dennischang928/Line-Follower/Paper/42d4a8cd9a13b9cb2ff5e50058281d6c.png

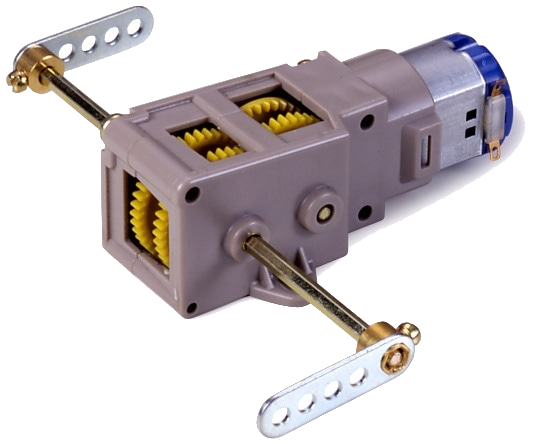
Paper/42d4a8cd9a13b9cb2ff5e50058281d6c.png
