dennischang928/Line-Follower/Paper/Minimalist modern Annual Report.pdf

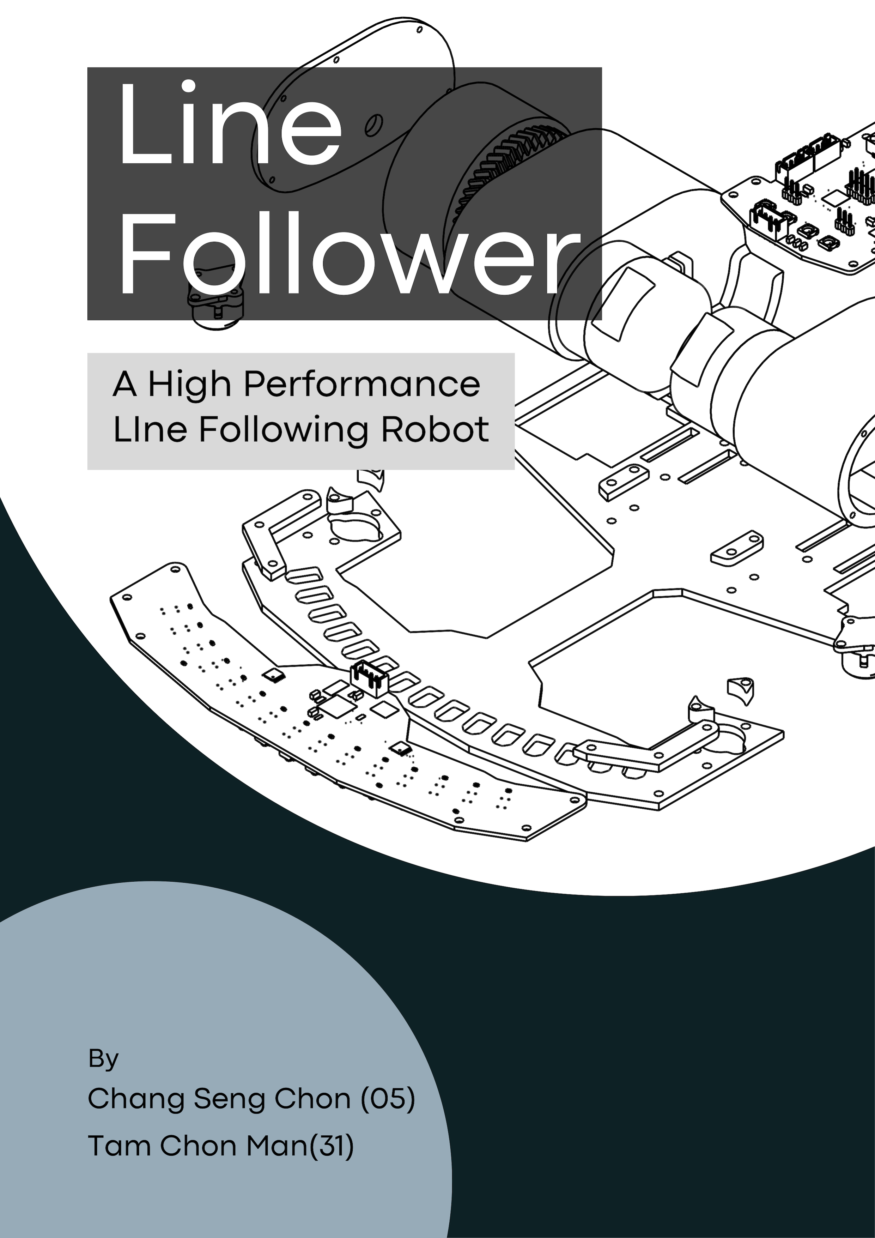
[picture p2: page 1]
