dennischang928/Line-Follower/Paper/Minimalist modern Annual Report (1).pdf

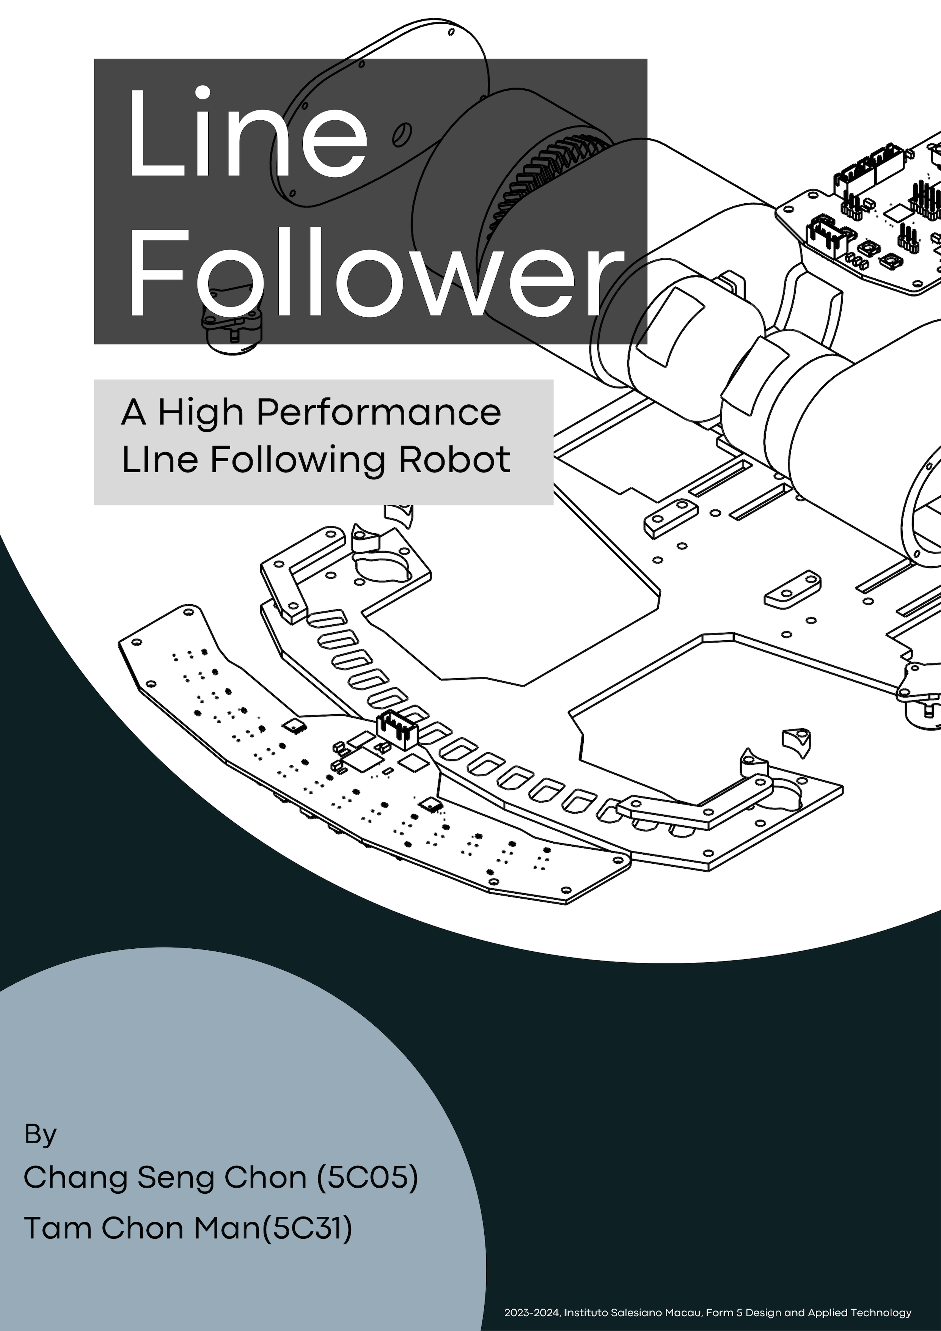
[picture p3: page 1]
