dennischang928/Line-Follower/Hardware/MotherBrd/CAMOUTPUT/MotherBrd v58.png

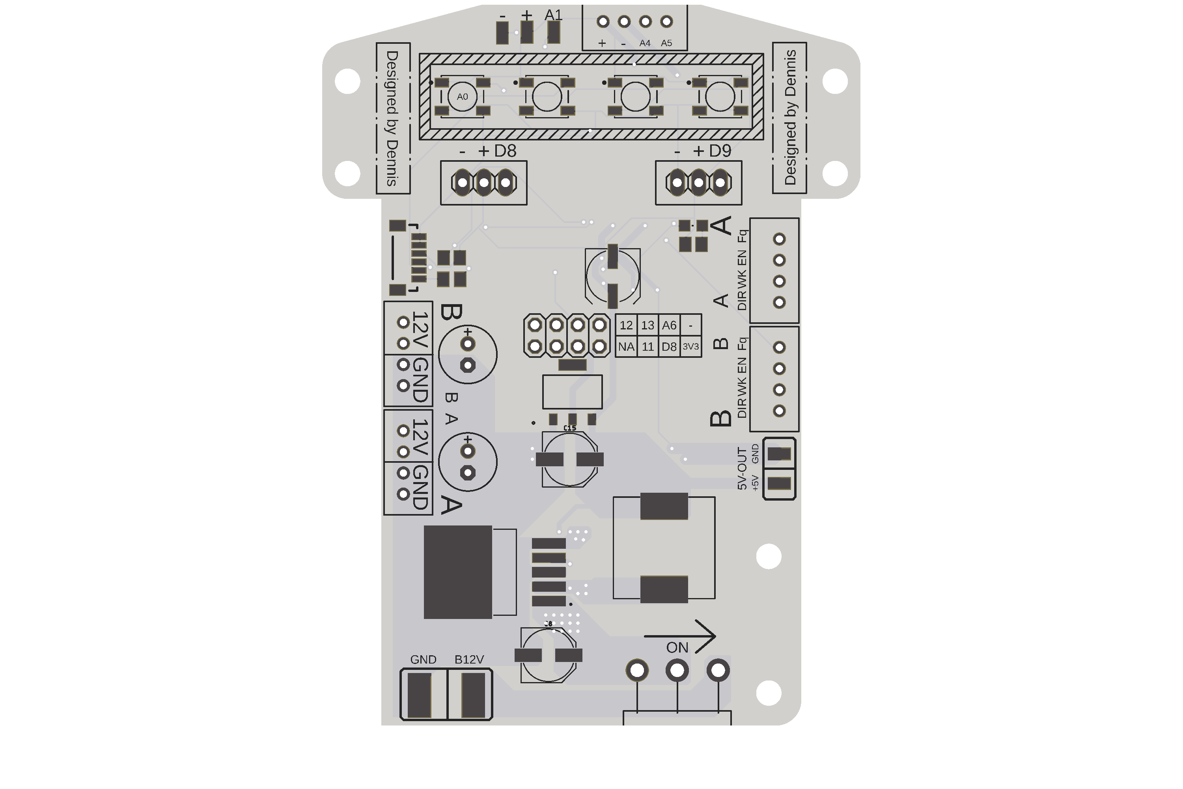
Hardware/MotherBrd/CAMOUTPUT/MotherBrd v58.png
