dennischang928/Line-Follower/Paper/Driving.png

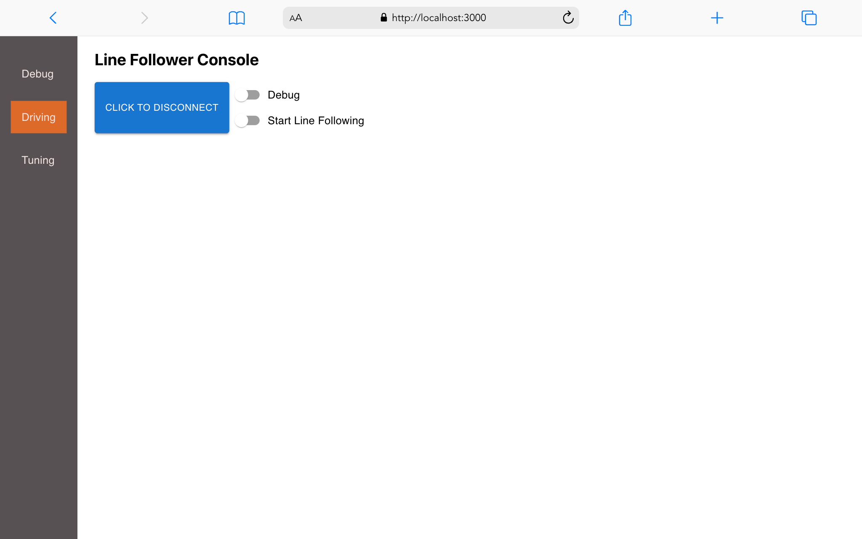
Paper/Driving.png
