dennischang928/Line-Follower/Paper/image.png

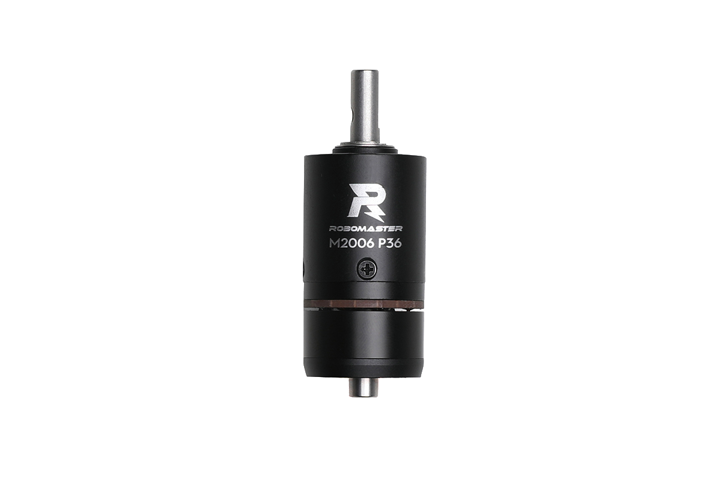
Paper/image.png
