dennischang928/Line-Follower/Paper/Macbook.jpeg

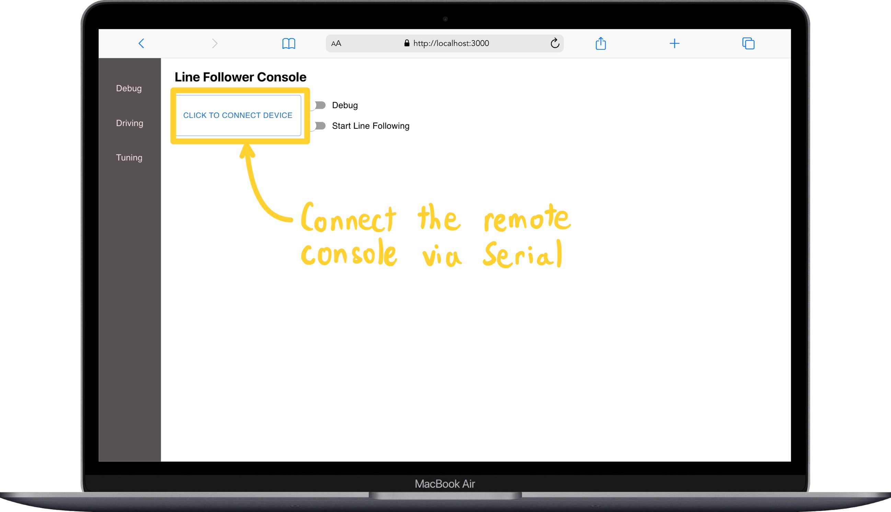
Paper/Macbook.jpeg
