dennischang928/Line-Follower/Paper/mobile.png

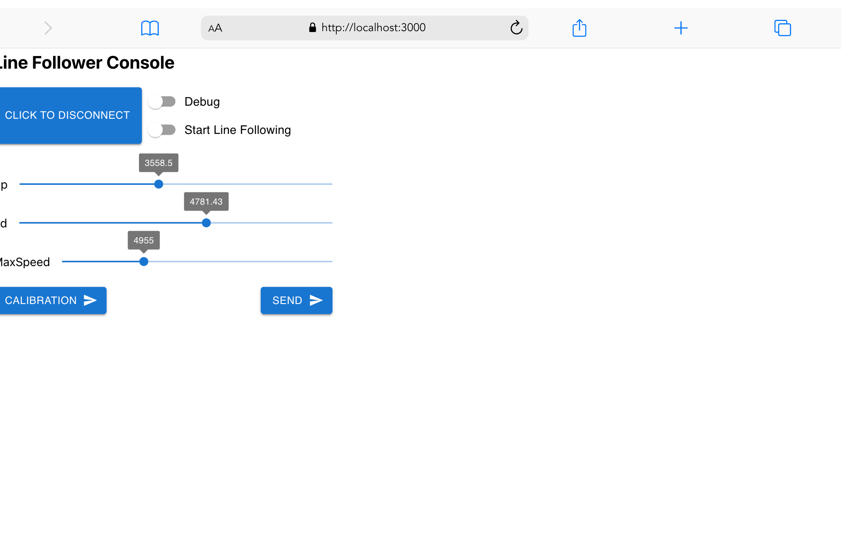
Paper/mobile.png
