dennischang928/Line-Follower/Paper/MotherBrd Buttom.png

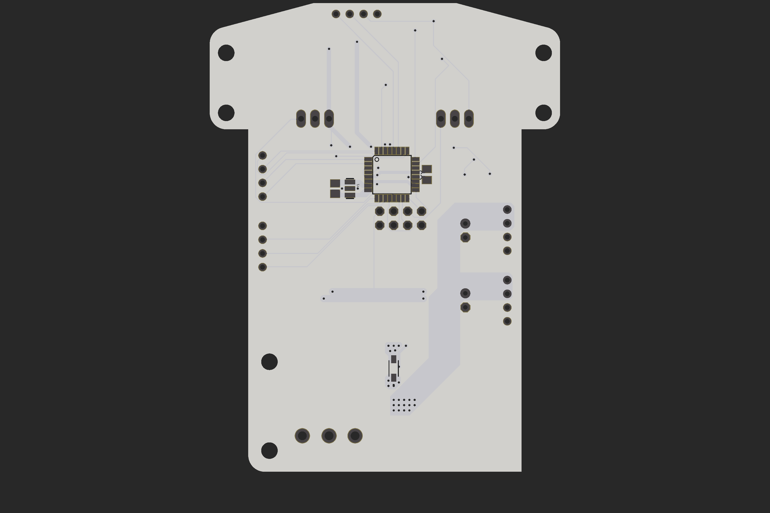
Paper/MotherBrd Buttom.png
