dennischang928/Line-Follower/Paper/Screenshot 2023-11-26 at 12.29.49 PM.png

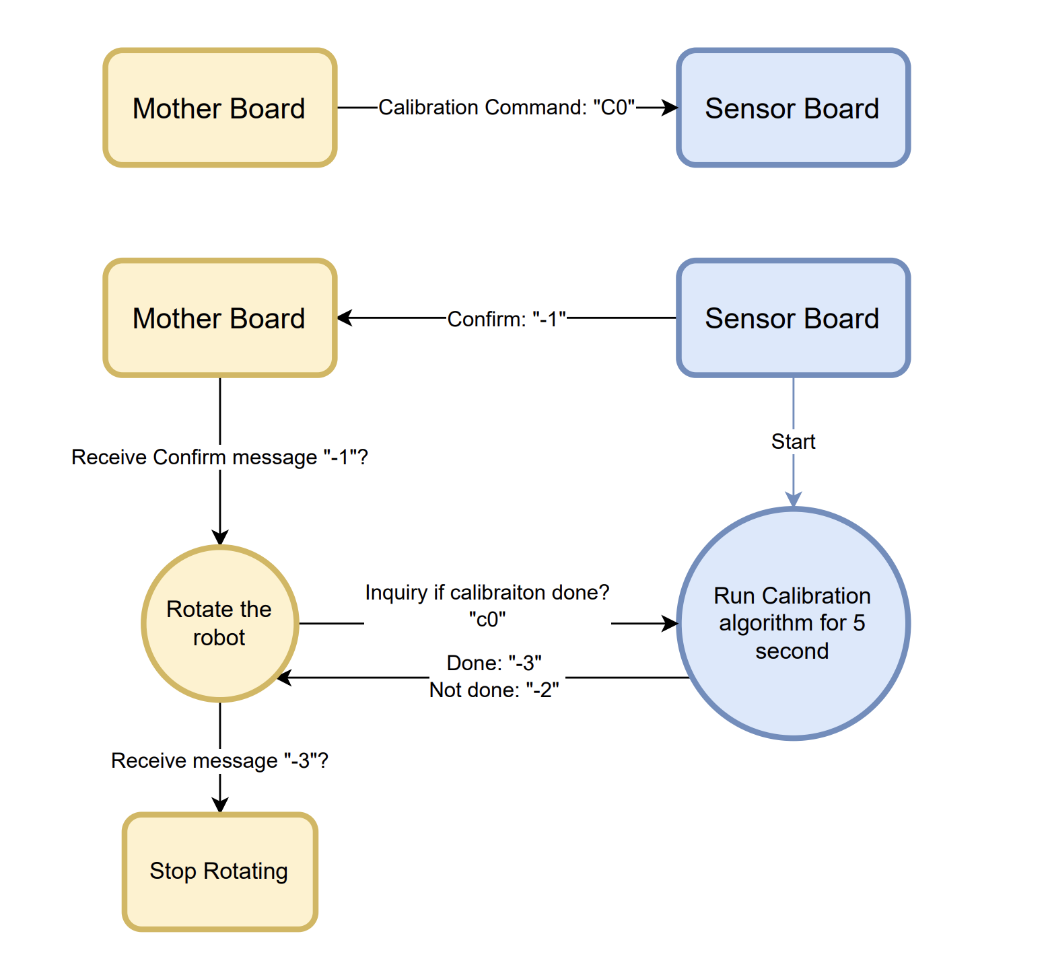
Paper/Screenshot 2023-11-26 at 12.29.49 PM.png
