dennischang928/Line-Follower/Paper/Screenshot 2023-11-26 at 12.39.15 PM.png

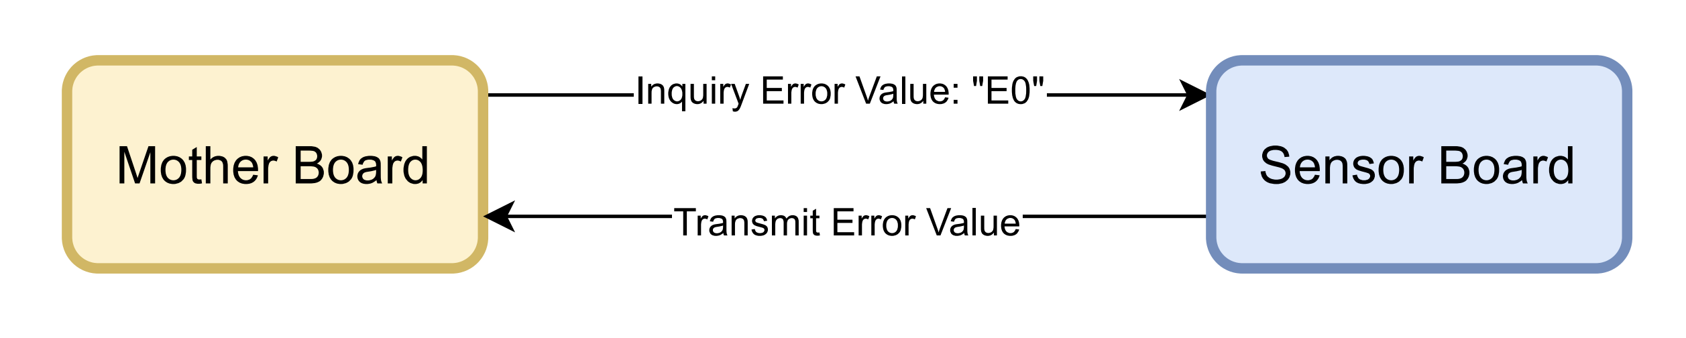
Paper/Screenshot 2023-11-26 at 12.39.15 PM.png
