dennischang928/Line-Follower/Paper/sensor v32.png

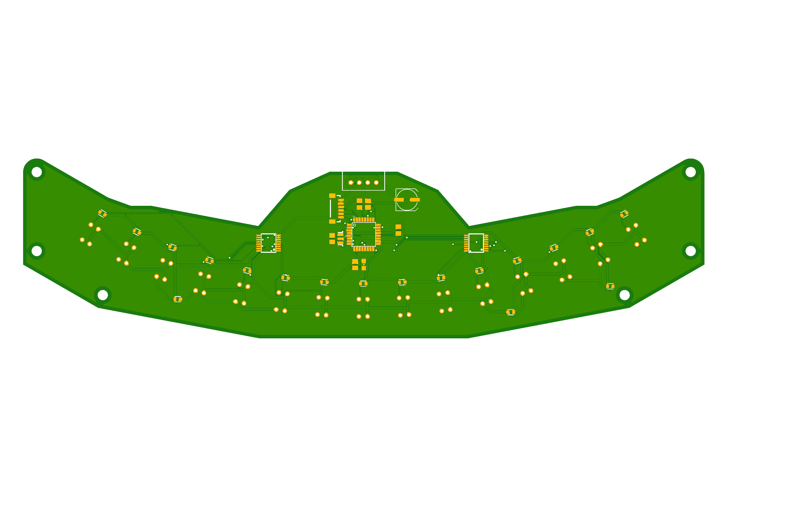
Paper/sensor v32.png
