dennischang928/Line-Follower/Paper/System flow chart.png

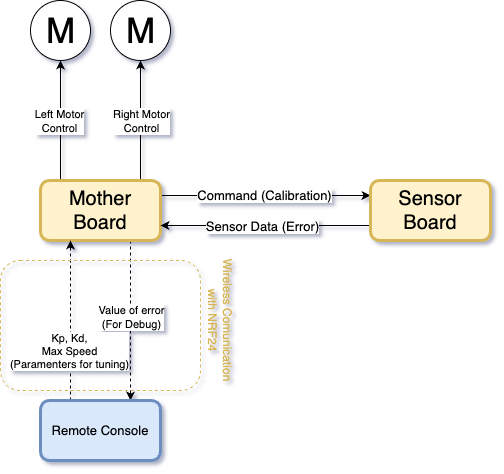
Paper/System flow chart.png
