dennischang928/Line-Follower/Hardware/Manufacter/Bottom_Brd.dxf

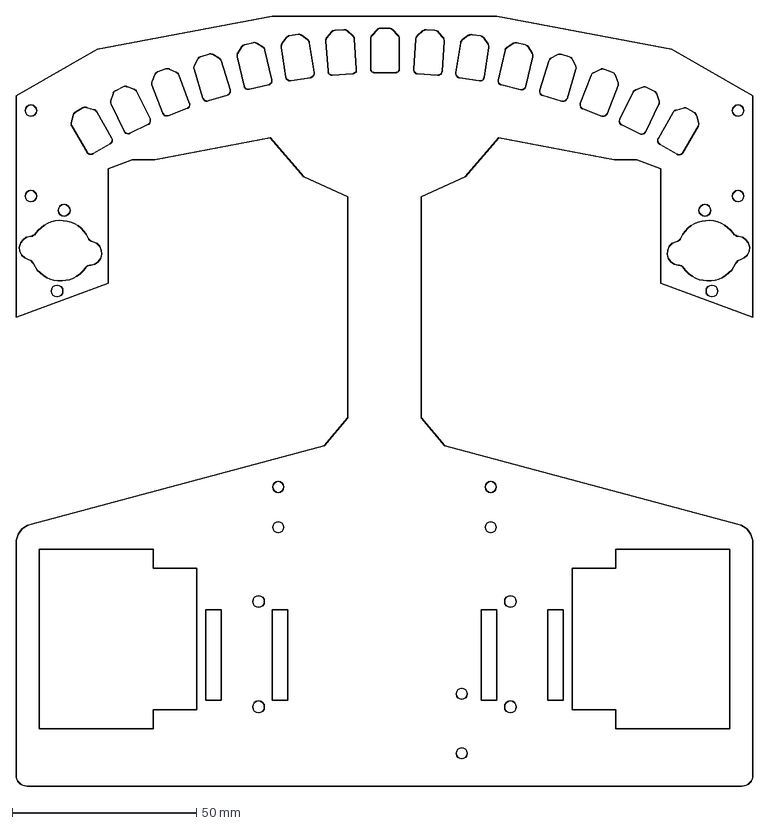
[picture p14: CAD file, 2023-11-18]
Hardware/Manufacter/Bottom_Brd.dxf
200.0 x 209.0 mm
