dennischang928/Line-Follower/Reference/brushless-4056-fan-1.snapshot.2/4056 Fan.STEP

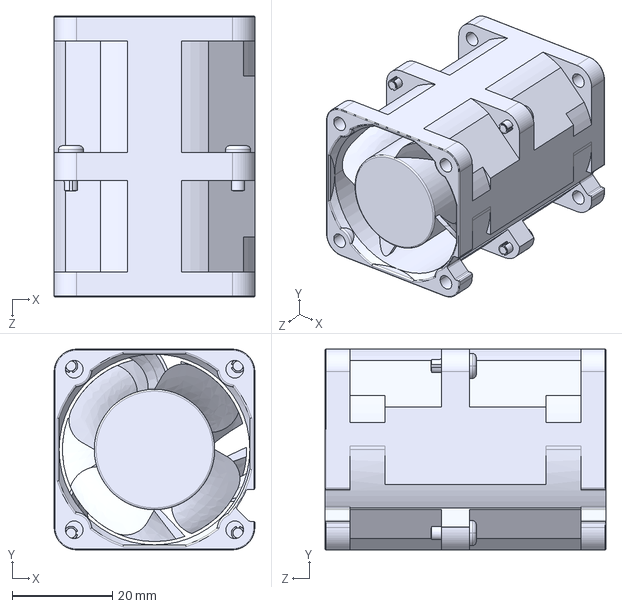
[picture p15: CAD file, 2023-11-18]
Reference/brushless-4056-fan-1.snapshot.2/4056 Fan.STEP
40.0 x 40.0 x 56.0 mm
