dennischang928/Line-Follower/Hardware/Manufacter/Base_Brd.dxf

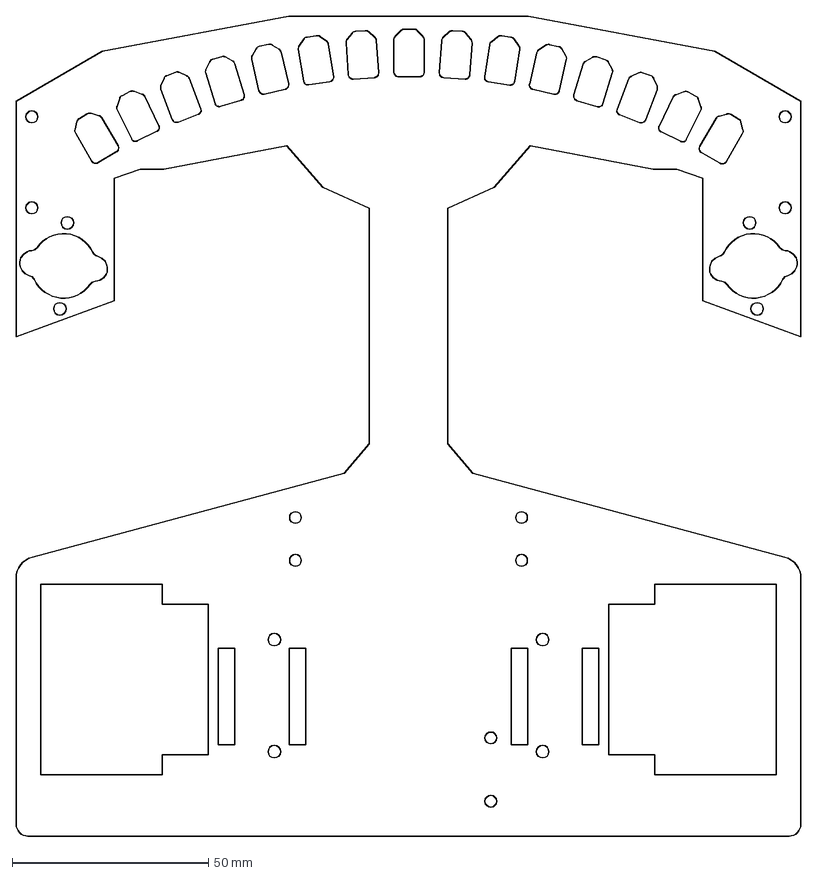
[picture p16: CAD file, 2023-11-18]
Hardware/Manufacter/Base_Brd.dxf
200.0 x 209.0 mm
