dennischang928/Line-Follower/Paper/Untitled Sheet1.dxf

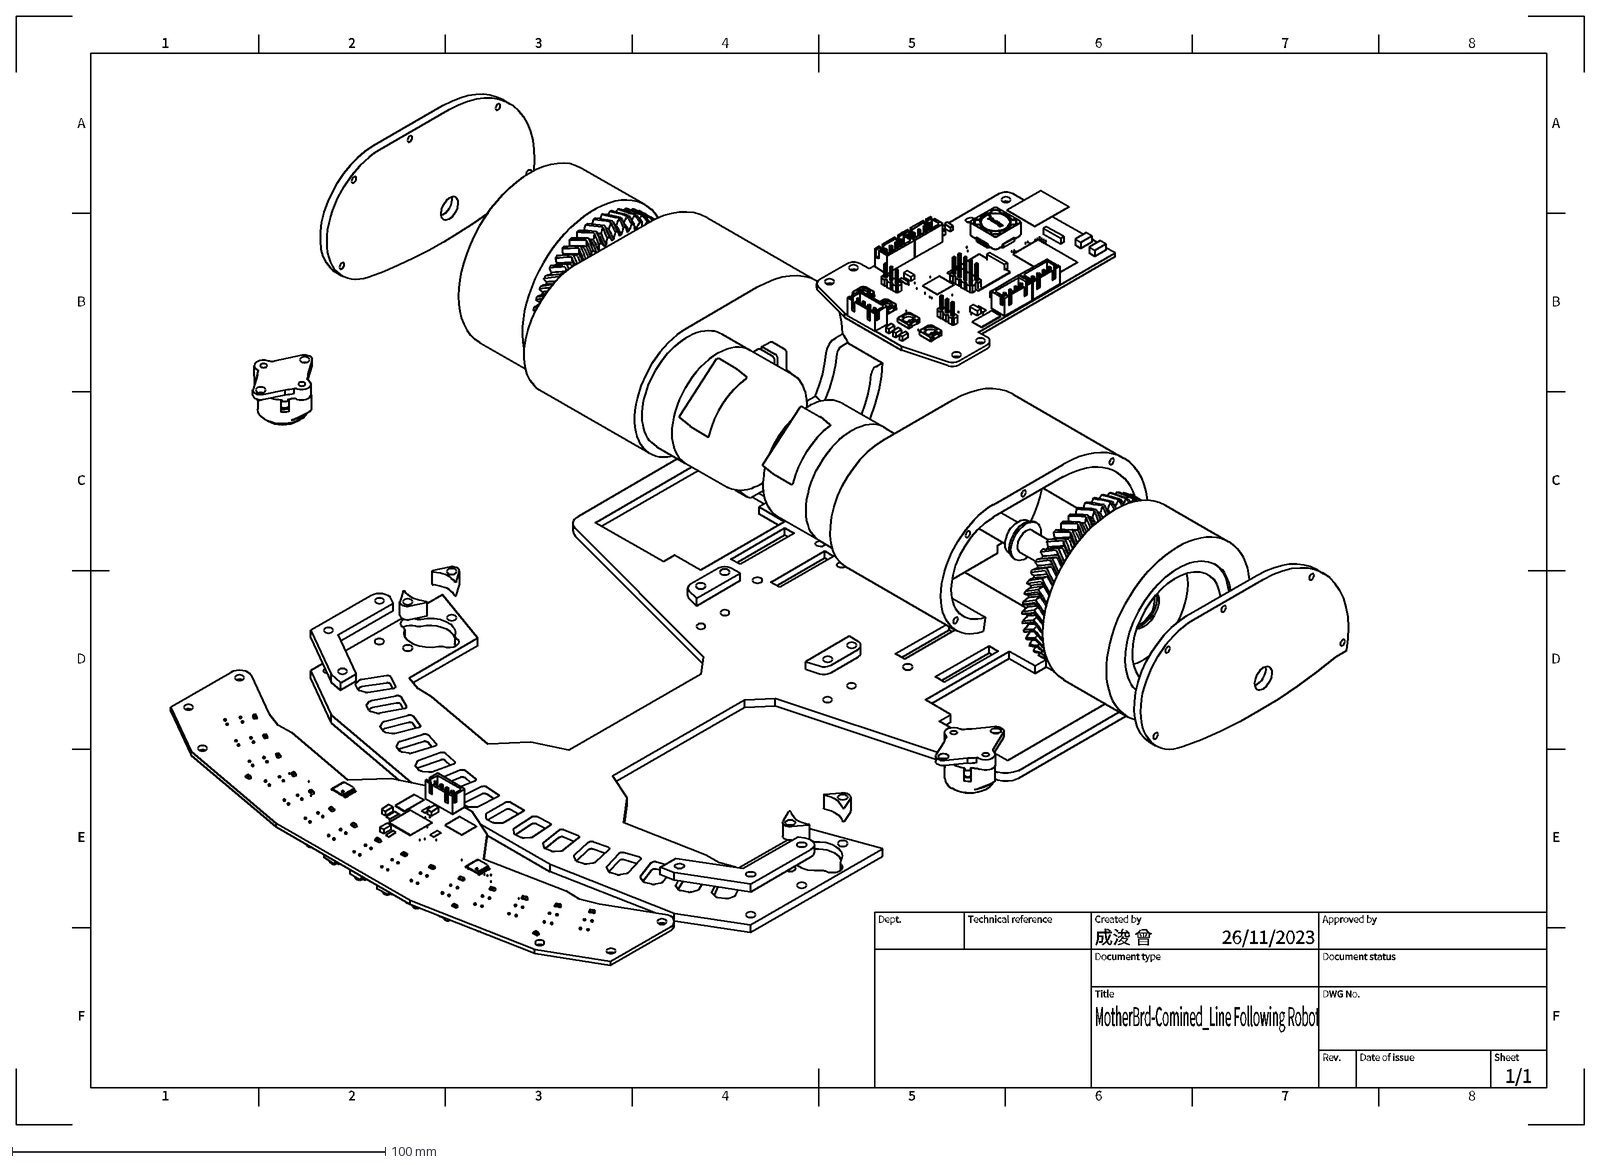
[picture p17: CAD file, 2024-01-31]
Paper/Untitled Sheet1.dxf
1
A
2
3
4
5
6
7
8
B
C
D
E
F
26/11/2023
1/1
MotherBrd-Comined_Line Following Robot
成浚 曾
Dept.
Technical reference
Created by
Approved by
Document type
Document status
Title
DWG No.
Rev.
Date of issue
Sheet
