dennischang928/Line-Follower/(list of files, cad)

Other CAD files:
Paper/Untitled.dwg
Paper/Gear Box Front View.dwg
