dennischang928/Line-Follower/Paper/Debug.jpeg

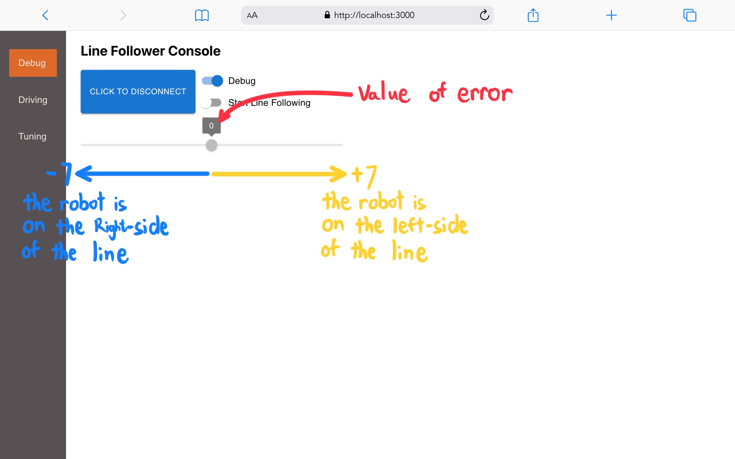
Paper/Debug.jpeg
