dennischang928/Line-Follower/Paper/Calibration.drawio.pdf

## Sensor Board

## Mother Board

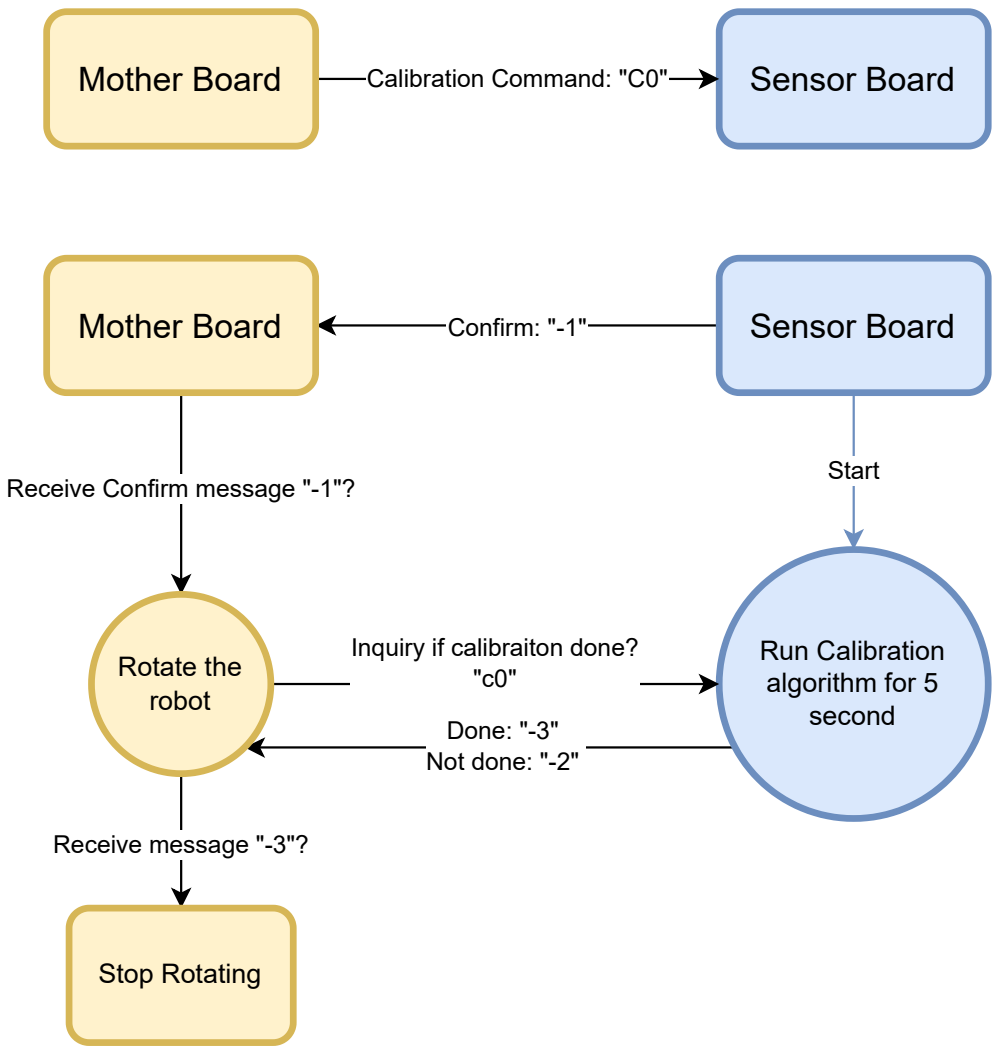
[picture p19: page 1]
Mother Board; Calibration Command: "C0"; Sensor Board; Confirm: "-1"; Start; Done: "-3" Not done: "-2"; Run Calibration algorithm for 5 second; Receive message "-3"?; Rotate the robot; Stop Rotating

Receive Confirm message "-1"?

Inquiry if calibraiton done?
