dennischang928/Line-Follower/Paper/drawio.pdf

# Sensor Board

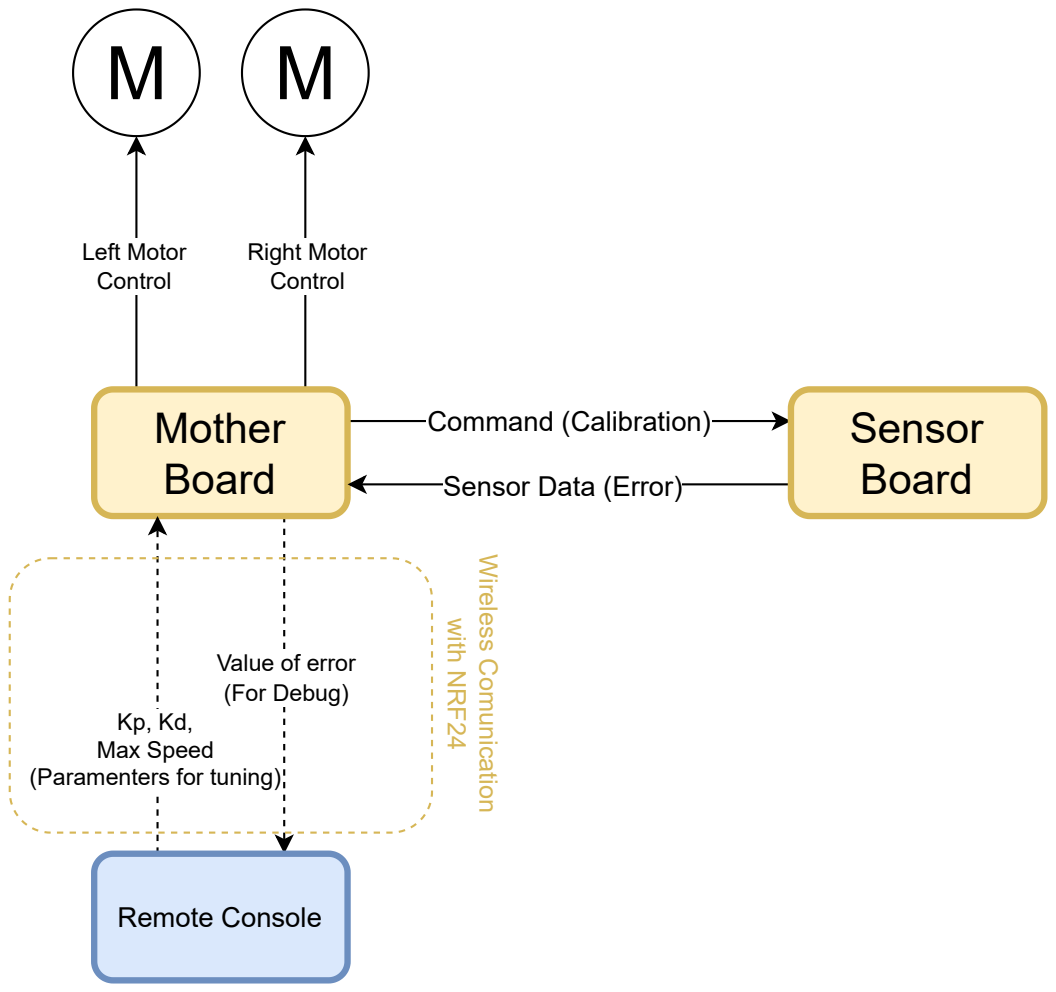
[picture p20: page 1]
Left Motor Control; Right Motor Control; Mother; Command (Calibration); Board; Sensor Data (Error); Remote Console; Wireless Comunication; with NRF24

Value of error
(For Debug)

Max Speed
(Paramenters for tuning)
