dennischang928/Line-Follower/Paper/Error Transmission.drawio.pdf

## Mother Board

## Sensor Board

Inquiry Error Value: "E0"

Transmit Error Value
