dennischang928/Line-Follower/Paper/sensor v14.pdf

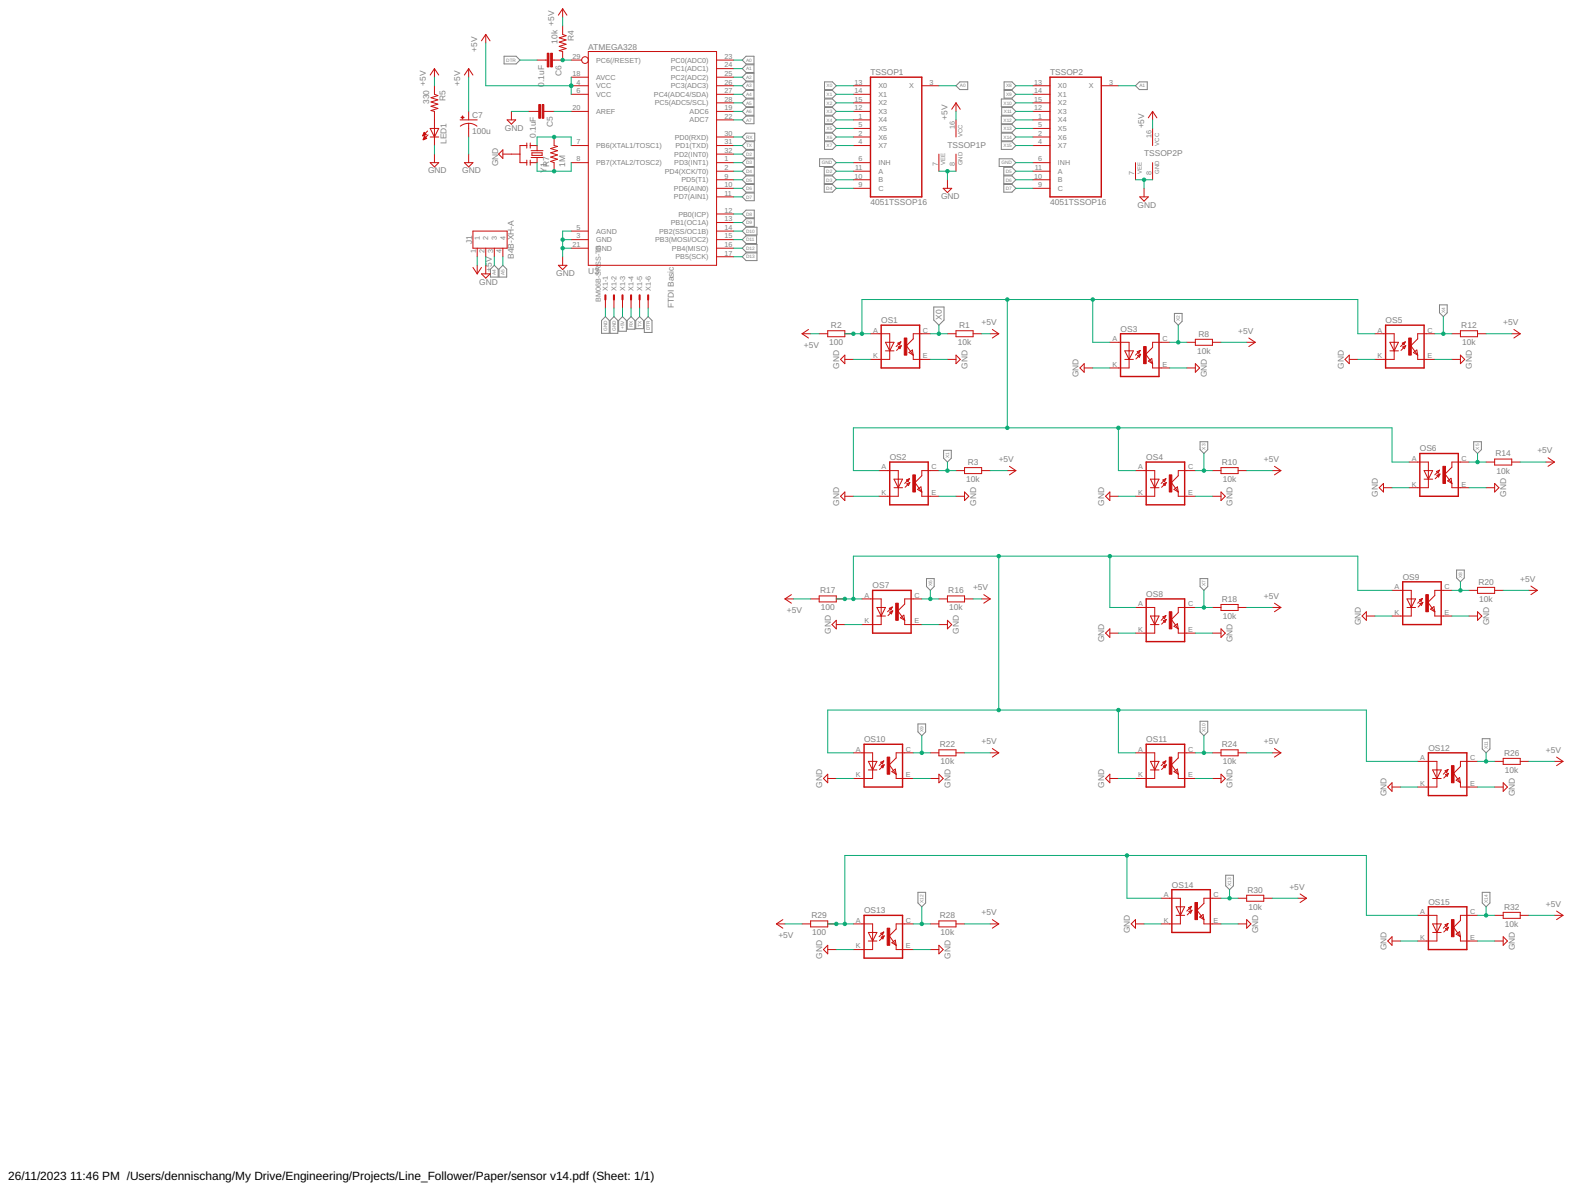
[picture p21: page 1]

26/11/2023 11:46 PM /Users/dennischang/My Drive/Engineering/Projects/Line_Follower/Paper/sensor v14.pdf (Sheet: 1/1)
