dennischang928/Line-Follower/Paper/MotherBrd v26.pdf

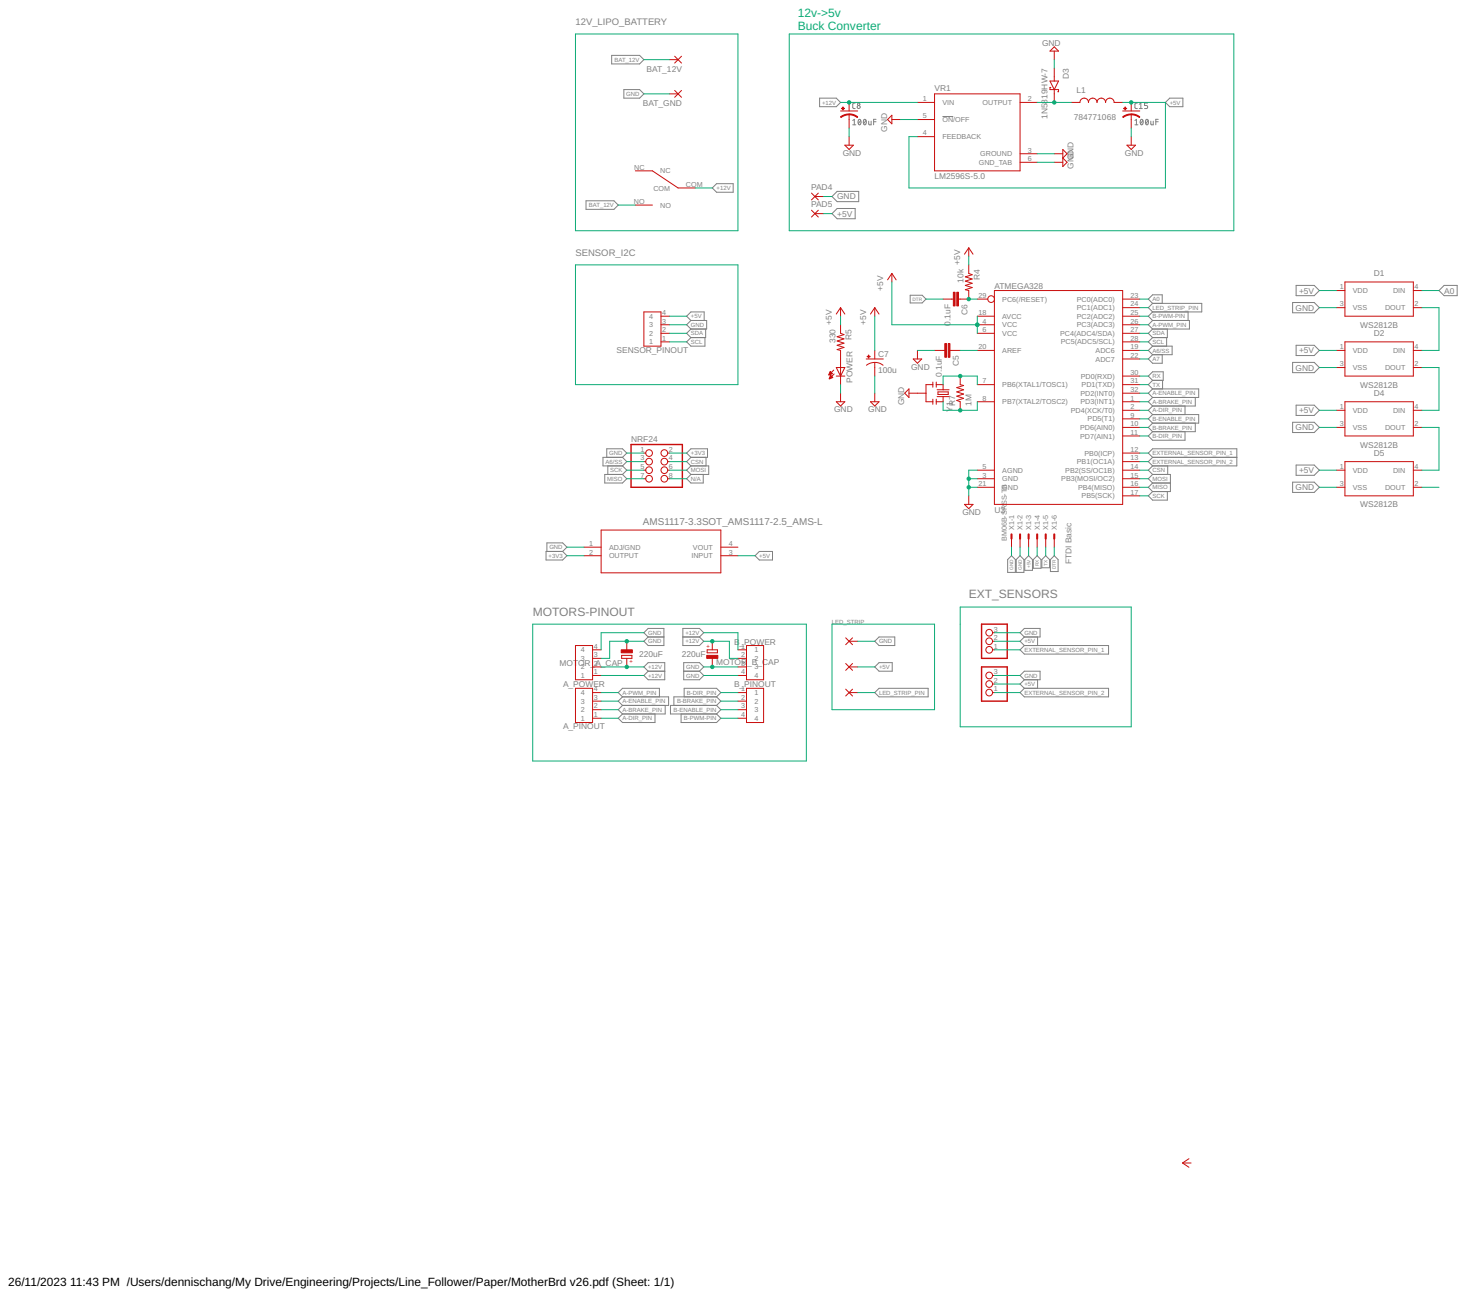
[picture p22: page 1]

26/11/2023 11:43 PM /Users/dennischang/My Drive/Engineering/Projects/Line_Follower/Paper/MotherBrd v26.pdf (Sheet: 1/1)
