dennischang928/Line-Follower/Hardware/MotherBrd/MotherBoard_v20.sch

## EAGLE design Hardware/MotherBrd/MotherBoard_v20.sch (2023-11-18)

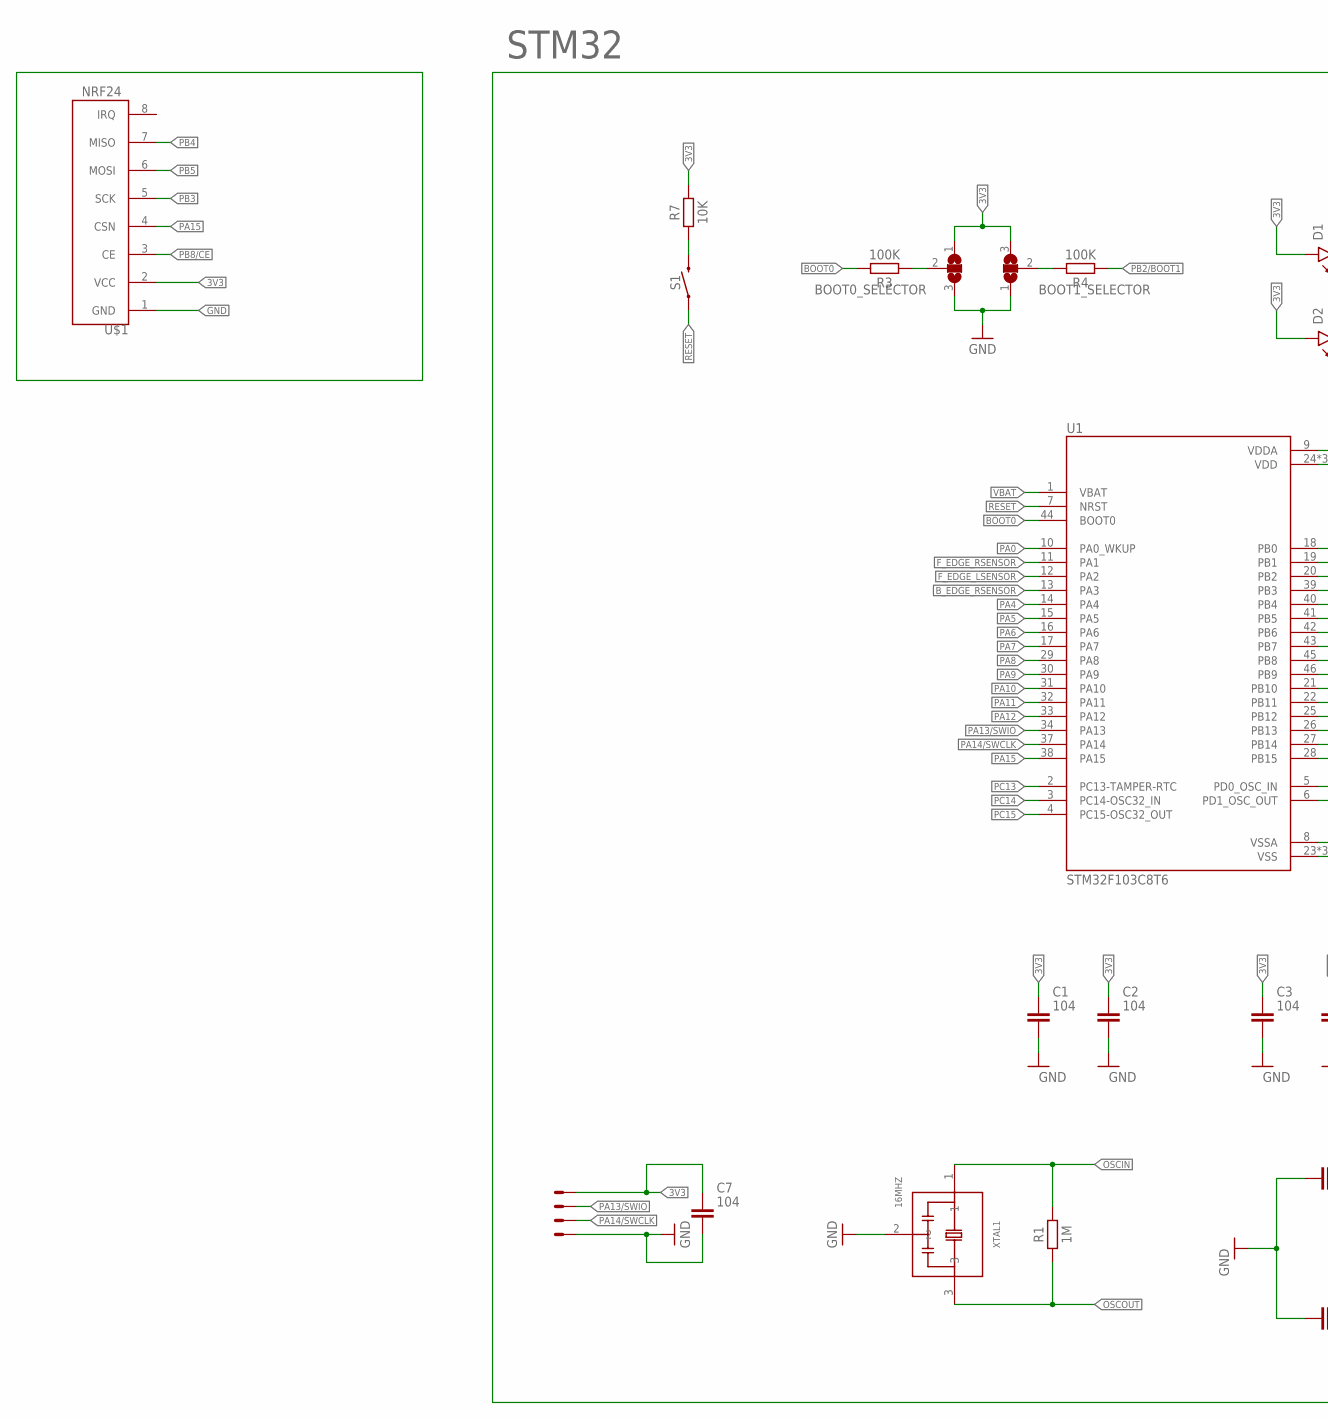
[picture p23: schematic MotherBoard_v20.sch, part in row 1, column 1]

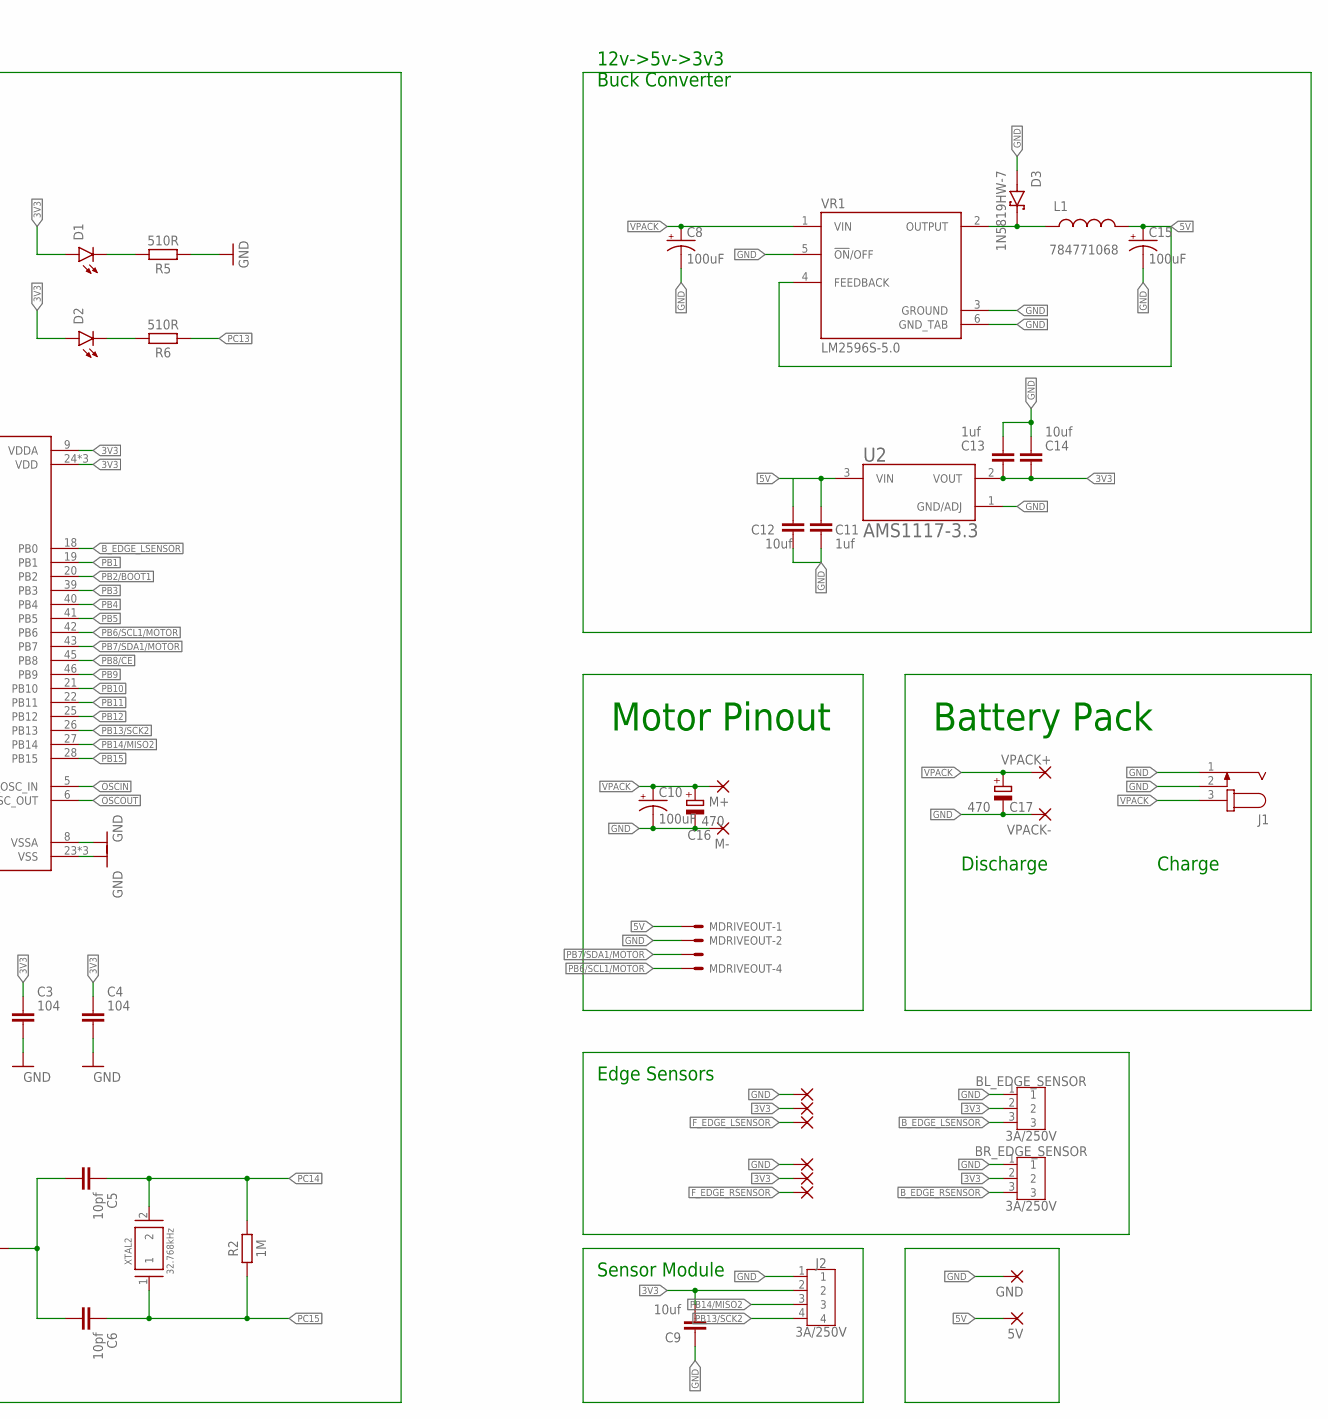
[picture p24: schematic MotherBoard_v20.sch, part in row 1, column 2]

Parts:
5V: WIREPADSMD5-1,8; 5-1,8
BL_EDGE_SENSOR: 3A/250V; B3B-XH-A
BOOT0_SELECTOR, BOOT1_SELECTOR: SJ2W; SJ_2
BR_EDGE_SENSOR: 3A/250V; B3B-XH-A
C1, C2, C3, C4, C7: 104; CAPC1608X85
C5, C6: 10pf; CAPC1608X85
C8, C10, C15: 100uF; PANASONIC_D
C9, C12, C14: 10uf; CAPC1608X85
C11, C13: 1uf; CAPC1608X85
C16, C17: 470; CAPPRD508W65D1000H1100B
D1, D2: LED_GREEN; LEDC2012X105N_RND-G
D3: 1N5819HW-7; SOD3715X145N
GND: WIREPADSMD5-1,8; 5-1,8
J1: JACK-PLUG0; SPC4077
J2: 3A/250V; B4B-XH-A
J-LINK-CONNECTOR: SM04B-SSR-H-TB
L1: 784771068
M+: WIREPADSMD5-1,8; 5-1,8
M-: WIREPADSMD5-1,8; 5-1,8
MDRIVEOUT: SM04B-SSR-H-TB
PAD1, PAD2, PAD3, PAD4, PAD5, PAD6: SMD2; SMD1,27-2,54
R1, R2: 1M; RESC1608X60
R3, R4: 100K; RESC1608X60
R5, R6: 510R; RESC1608X60
R7: 10K; RESC1608X60
S1: MOMENTARY-SWITCH-SPST-SMD-6.0X3.5MM; TACTILE_SWITCH_SMD_6.0X3.5MM
U1: STM32F103C8T6; QFP50P900X900X160-48N
U2: AMS1117-3.3; SOT229P700X180-4N
U$1: NRF24
VPACK+: SMD5; SMD2,54-5,08
VPACK-: SMD5; SMD2,54-5,08
VR1: LM2596S-5.0; TO170P1524X483-6N
XTAL1: 16MHZ; OSC_CSTCE8M00G55-R0
XTAL2: 32.768kHz; XTAL_ABS07-32.768KHZ-T

Connections:
3V3: BL_EDGE_SENSOR.2, BOOT0_SELECTOR.1, BOOT1_SELECTOR.3, BR_EDGE_SENSOR.2, C1.1, C2.1, C3.1, C4.1, C7.1, C9.2, C13.2, C14.2, D1.A, D2.A, J2.2, J-LINK-CONNECTOR.4, PAD2.1, PAD5.1, R7.2, U1.9 (VDDA), U1.24 (VDD), U2.2 (VOUT), U$1.2 (VCC)
5V: 5V.1, C11.1, C12.1, C15.+, L1.2, MDRIVEOUT.1, U2.3 (VIN), VR1.4 (FEEDBACK)
B00T1: BOOT1_SELECTOR.2, R4.2
BOOT0: R3.2, U1.44 (BOOT0)
B_EDGE_LSENSOR: BL_EDGE_SENSOR.3, U1.18 (PB0)
B_EDGE_RSENSOR: BR_EDGE_SENSOR.3, U1.13 (PA3)
F_EDGE_LSENSOR: PAD3.1, U1.12 (PA2)
F_EDGE_RSENSOR: PAD6.1, U1.11 (PA1)
GND: BL_EDGE_SENSOR.1, BOOT0_SELECTOR.3, BOOT1_SELECTOR.1, BR_EDGE_SENSOR.1, C1.2, C2.2, C3.2, C4.2, C5.2, C6.2, C7.2, C8.-, C9.1, C10.-, C11.2, C12.2, C13.1, C14.1, C15.-, C16.2 (-), C17.2 (-), D3.A, GND.1, J1.1, J1.2, J2.1, J-LINK-CONNECTOR.1, M-.1, MDRIVEOUT.2, PAD1.1, PAD4.1, R5.1, U1.8 (VSSA), U1.23 (VSS), U2.1 (GND/ADJ), U$1.1 (GND), VPACK-.1, VR1.3 (GROUND), VR1.5 (!ON!/OFF), VR1.6 (GND_TAB), XTAL1.2
unnamed: D2.C, R6.2
unnamed: BOOT0_SELECTOR.2, R3.1
unnamed: D1.C, R5.2
unnamed: R7.1, S1.2
OSCIN: R1.2, U1.5 (PD0_OSC_IN), XTAL1.1
OSCOUT: R1.1, U1.6 (PD1_OSC_OUT), XTAL1.3
PA0: U1.10 (PA0_WKUP)
PA4: U1.14 (PA4)
PA5: U1.15 (PA5)
PA6: U1.16 (PA6)
PA7: U1.17 (PA7)
PA8: U1.29 (PA8)
PA9: U1.30 (PA9)
PA10: U1.31 (PA10)
PA11: U1.32 (PA11)
PA12: U1.33 (PA12)
PA13/SWIO: J-LINK-CONNECTOR.3, U1.34 (PA13)
PA14/SWCLK: J-LINK-CONNECTOR.2, U1.37 (PA14)
PA15: U1.38 (PA15), U$1.4 (CSN)
PB1: U1.19 (PB1)
PB2/BOOT1: R4.1, U1.20 (PB2)
PB3: U1.39 (PB3), U$1.5 (SCK)
PB4: U1.40 (PB4), U$1.7 (MISO)
PB5: U1.41 (PB5), U$1.6 (MOSI)
PB6/SCL1/MOTOR: MDRIVEOUT.4, U1.42 (PB6)
PB7/SDA1/MOTOR: MDRIVEOUT.3, U1.43 (PB7)
PB8/CE: U1.45 (PB8), U$1.3 (CE)
PB9: U1.46 (PB9)
PB10: U1.21 (PB10)
PB11: U1.22 (PB11)
PB12: U1.25 (PB12)
PB13/SCK2: J2.4, U1.26 (PB13)
PB14/MISO2: J2.3, U1.27 (PB14)
PB15: U1.28 (PB15)
PC13: R6.1, U1.2 (PC13-TAMPER-RTC)
PC14: C5.1, R2.2, U1.3 (PC14-OSC32_IN), XTAL2.2
PC15: C6.1, R2.1, U1.4 (PC15-OSC32_OUT), XTAL2.1
RESET: S1.1, U1.7 (NRST)
VBAT: U1.1 (VBAT)
VOUT: D3.C (K), L1.1, VR1.2 (OUTPUT)
VPACK: C8.+, C10.+, C16.1 (+), C17.1 (+), J1.3, M+.1, VPACK+.1, VR1.1 (VIN)

Notes on the sheet:
12v->5v->3v3 Buck Converter
Motor Pinout
Battery Pack
Sensor Module
Edge Sensors
Discharge
Charge
