dennischang928/Line-Follower/(commit log)

2023-11-18 Line Follower 1st commit
    [4056 Fan.STEP, Base_Brd.dxf, Bottom_Brd.dxf, MotherBoard_v20.sch]
2023-11-26 Finalized the entire project
    [Gear Box Front View.dwg]
2024-01-31 Project Finalized
    [Untitled Sheet1.dxf, Untitled.dwg]
